fiuba-labo-de-micro-miercoles/2019-2c-primer-proyecto-arilow/doc/otros/links.md

# links utilizados

## partes
<https://articulo.mercadolibre.com.ar/MLA-620477671-convertidor-dc-dc-boost-elevador-tension-step-up-mt3608-mona-_JM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>
<https://candy-ho.com/producto/bluetooth-hc05-maestro-esclavo-uart-ttl-at-arduino/>

## proyectos similares
<https://www.prometec.net/mblock-4bot-movimientos/>
<https://makezine.com/2016/11/22/robot-quadruped-arduino-program/>

## joystick ps2
<https://virushardrive.wordpress.com/tag/robot-cuadrupedo-arduino/> (joystick ps2)
<http://www.rhydolabz.com/wiki/?p=12663>
<https://github.com/madsci1016/Arduino-PS2X>

## HC-SR04
<https://circuitdigest.com/microcontroller-projects/distance-measurement-using-hc-sr04-avr>
