fiuba-labo-de-micro-miercoles/2019-2c-primer-proyecto-arilow/(list of files, cad)

Other CAD files:
codigo/default/Proyecto.obj
codigo/Proyecto.obj
