fiuba-labo-de-micro-miercoles/2019-2c-primer-proyecto-arilow/(threads)

Thread 2 (2019-12-09):

Se subió el informe del trabajo terminado

arilow, 2019-12-09:
Hola profes!! ahí subimos el informe terminado de acuerdo a las correciones hechas el miércoles pasado.

Pregunta: habrá chance de poder rendir final la primera fecha?

Desde ya muchas gracias

Thread 3 (2019-12-10):

Cuenta decimal o hexadecimal

PucciFernando, 2019-12-10:
Angulos.inc lineas desde 12 a 54...
Me parece que hay un error. Cuenta de 8 en 8 en decimal, pero expresa las direcciones en hexa.
0x500, 0x508, 0x516 en lugar de 0x510, etc.
Arrastra el error. ¿puede ser?

PucciFernando, 2019-12-10:
De ese issue, la carga de la tabla con las definiciones de las variables de ANG_YAW_xxx  no concuerdan, hay desfasajes

arilow, 2019-12-11:
Sisis profe, es un error. Ahí lo arreglamos

Thread 4 (2019-12-10):

Etiqueta huerfana?

PucciFernando, 2019-12-10:
Consulto: librería I2C.inc: linea 58
Donde salta la etiqueta errloop?

arilow, 2019-12-11:
Buen dia profe. Esa etiqueta esta en el main. Esta pensada para usarse en casa de que puede haber cualquier tipo de error. Deberíamos ponerla en otro archivo?

PucciFernando, 2019-12-11:
En el i2c si hay un error no salten al main. Hagan el loop ahí o respeten por las dudas. O duerman al micro mejor.

Closed 2019-12-11.

Thread 5 (2019-12-10):

Consejo de Macro o rutina

PucciFernando, 2019-12-10:
Hay muchos codigo copiados y pegados de este tipo:
	LDI		LEG_L,LOW(LEG_2)
	LDI		LEG_H,HIGH(LEG_2)
	LDI		XL,LOW(ANG_YAW_180)
	LDI		XH,HIGH(ANG_YAW_180)

No se puede quizás hacer una rutina o una macro, pasando como parametros el LEG y el YAW?
Sería mas claro, corto y mas confiable.
Pero es un consejo
