fiuba-labo-de-micro-miercoles/2019-2c-primer-proyecto-arilow/(commit log)

2019-09-26 se agrego i2c
2019-10-24 se mejoro el codigo de i2c y se aniadieron rutinas de servos
    [Proyecto.obj]
2019-10-30 movement test
    [Proyecto.obj]
2019-10-31 fix movement test
    [Proyecto.obj]
2019-11-15 se crearon rutinas para mover piernas
    [Proyecto.obj]
2019-11-25 fix archivos en carpeta codigo
    [Proyecto.obj]
2019-11-26 fix cambios movimiento
    [Proyecto.obj]
2019-11-26 se agrego bluetooth
    [Proyecto.obj]
2019-11-26 se eliminaron variables innecesarias
    [Proyecto.obj]
2019-11-27 sensor borrado
    [Proyecto.obj]
2019-11-29 wilson detecta paredes
    [Proyecto.obj]
2019-12-03 cambios movimiento
    [Proyecto.obj]
2019-12-11 corregidas pociciones de arreglamos en ram
